develsvai/PROJECT_AC_SPOT_WELDER/firmware/new_architecture/sim_ui/index.html

# AC Spot Welder Simulator

이 화면은 단순 목업이 아니라 실제 `new_architecture` C 시뮬레이터 상태를 읽습니다. 버튼을 누르거나 시간을 진행시키면 LCD, UI 상태, Process 상태, Auto Detect 상태가 같이 변해야 정상입니다.

Virtual Time

0 ms

실제 시간이 아니라 시뮬레이터 내부에서 흐른 가상 시간입니다.

Time

50 ms

Multiplier

1

Rest

200 ms

Mode

MANUAL

Apply Settings Reload Visible Values

## Spot Progress

READY

용접 입력을 기다리는 상태입니다.

## Live State

UI State

Process State

Auto Detect

Current Menu

Pulse Count

0

Weld Count

0

TRIAC output active

Buzzer active

Contact stimulus active

Spot currently firing

## State Meaning

UI

현재 화면 상태 설명

Process

현재 용접 FSM 설명

Auto Detect

현재 자동 감지 상태 설명

Menu

현재 선택된 메뉴 항목 설명

## Event Log

최신 로그가 위에 쌓입니다. 자동 스팟은 보통 `접촉 감지 -> 대기 -> 펄스 출력 -> 완료 -> lockout` 순으로 보면 됩니다.

## Controls

Manual Weld

수동 모드 전용입니다. 이제 시뮬레이터에서는 버튼을 누르면 필요한 시간까지 자동으로 흘려서 결과가 바로 보입니다.

Manual Weld

Contact Input

AUTO 모드에서는 `Touch Pulse`가 가장 직관적입니다. 접촉을 한번 만들고 해제해서 자동 감지와 용접을 한 사이클로 보여줍니다.

Contact Off Touch Pulse

Simulation Tools

`Warm Up 1s`는 부팅 직후 splash를 넘기고 auto detect baseline을 안정시키는 용도입니다. `Reset`은 초기 상태로 되돌립니다.

Warm Up 1s Reset
