develsvai/PROJECT_AC_SPOT_WELDER/assets/images/board.png

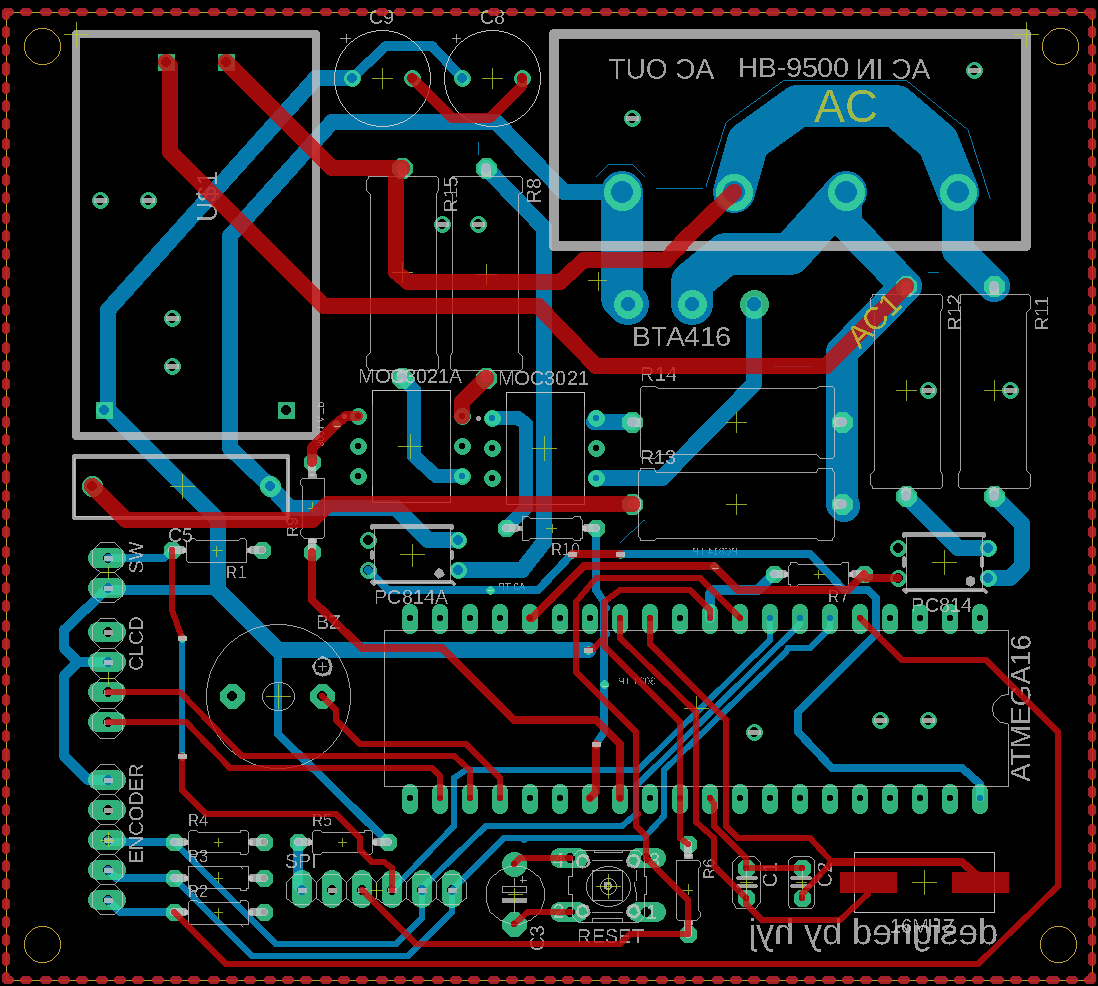
assets/images/board.png
