develsvai/PROJECT_AC_SPOT_WELDER/assets/images/board_3D_1.png

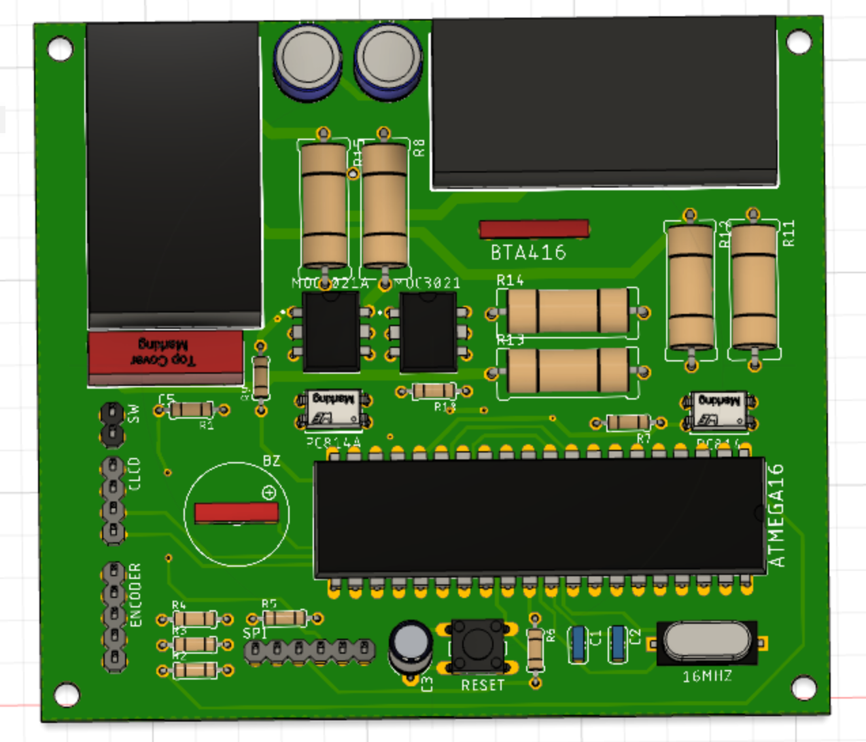
assets/images/board_3D_1.png
