develsvai/PROJECT_AC_SPOT_WELDER/assets/images/board_3D_2.png

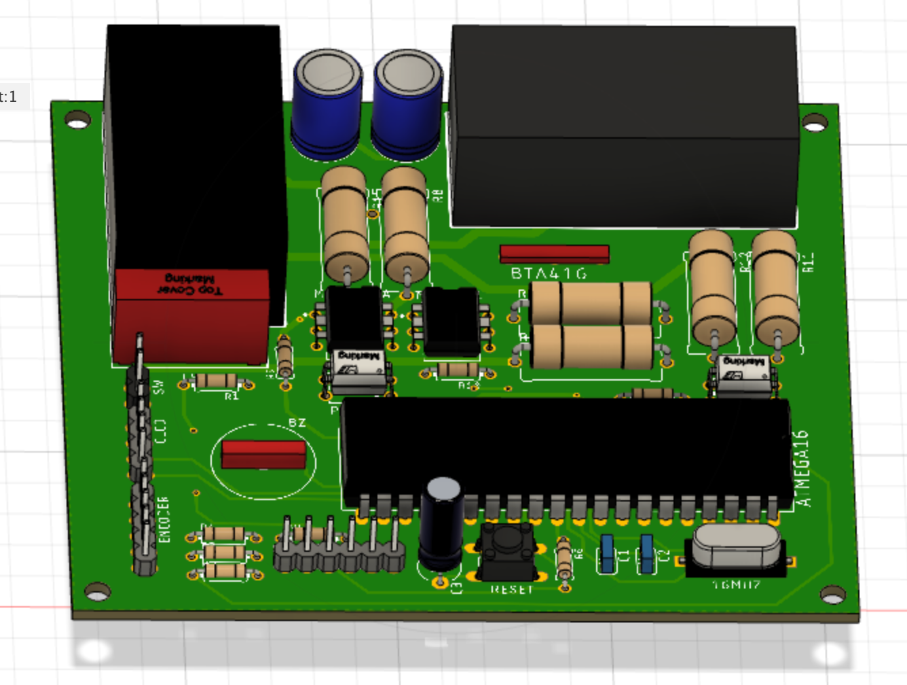
assets/images/board_3D_2.png
