develsvai/PROJECT_AC_SPOT_WELDER/assets/images/pcb_board_bottom.png

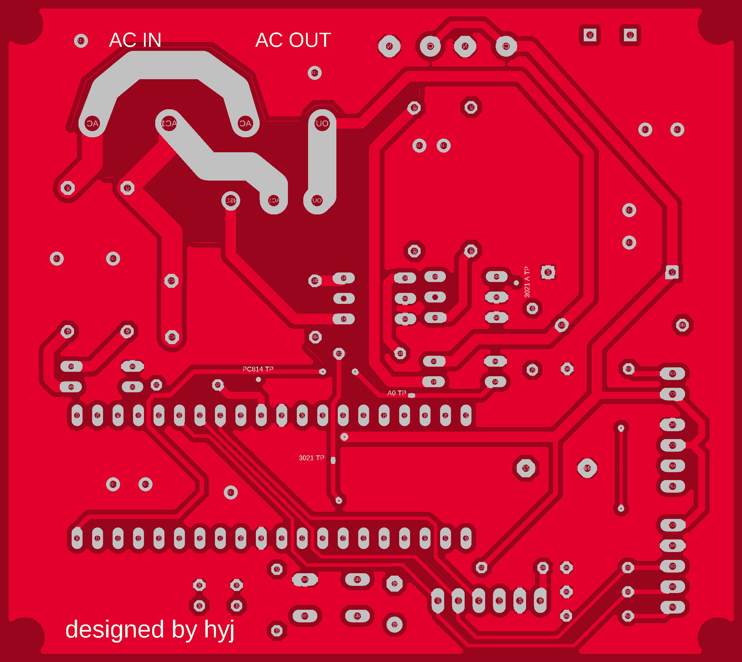
assets/images/pcb_board_bottom.png
