develsvai/PROJECT_AC_SPOT_WELDER/assets/images/pcb_board_top.png

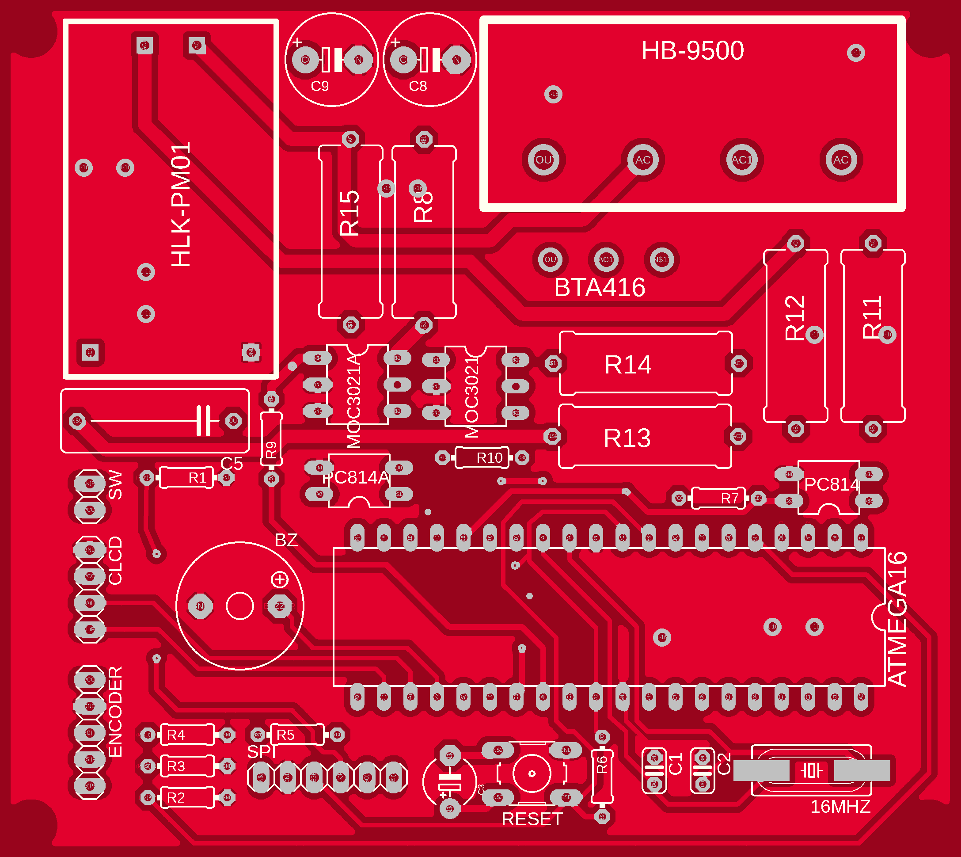
assets/images/pcb_board_top.png
