develsvai/PROJECT_AC_SPOT_WELDER/assets/images/product_1.jpeg

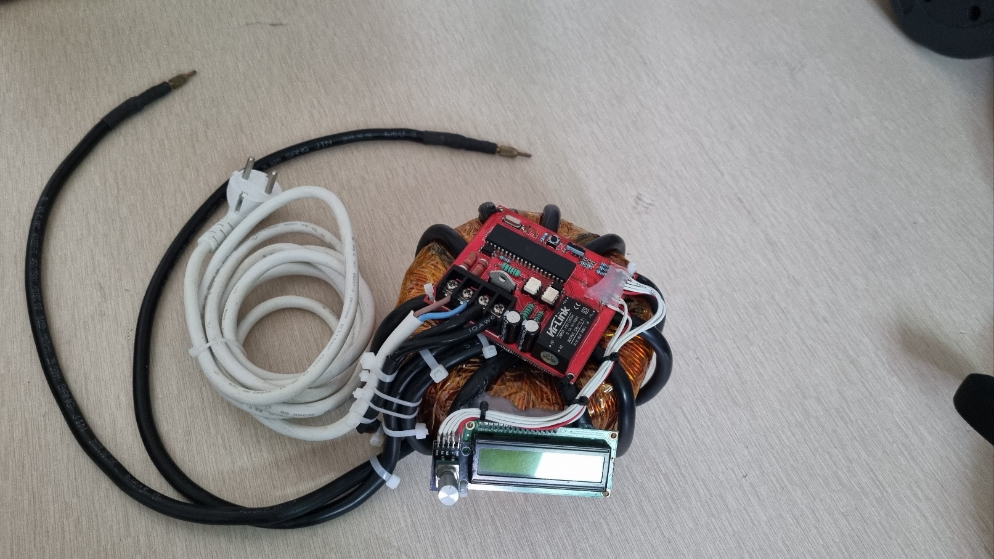
assets/images/product_1.jpeg
