develsvai/PROJECT_AC_SPOT_WELDER/assets/images/product_2.jpeg

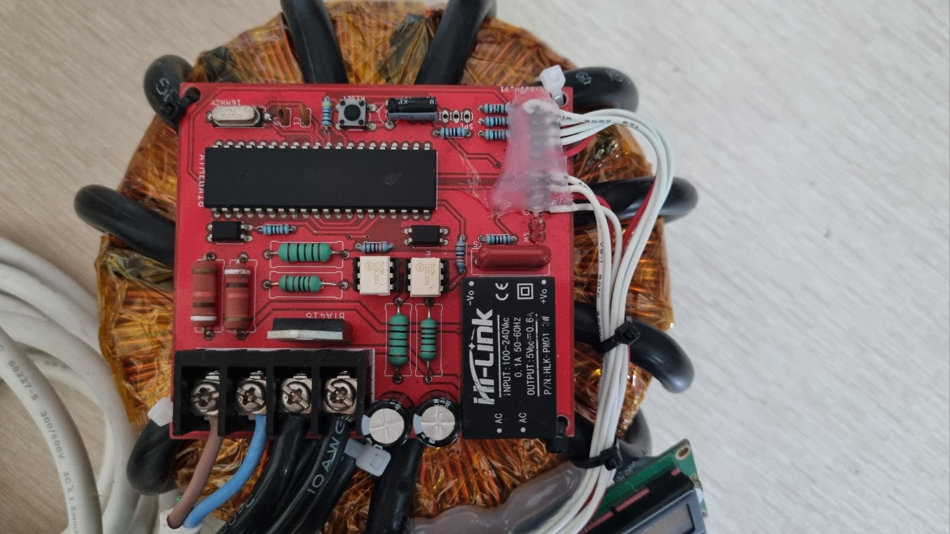
assets/images/product_2.jpeg
