develsvai/PROJECT_AC_SPOT_WELDER/assets/images/shema.png

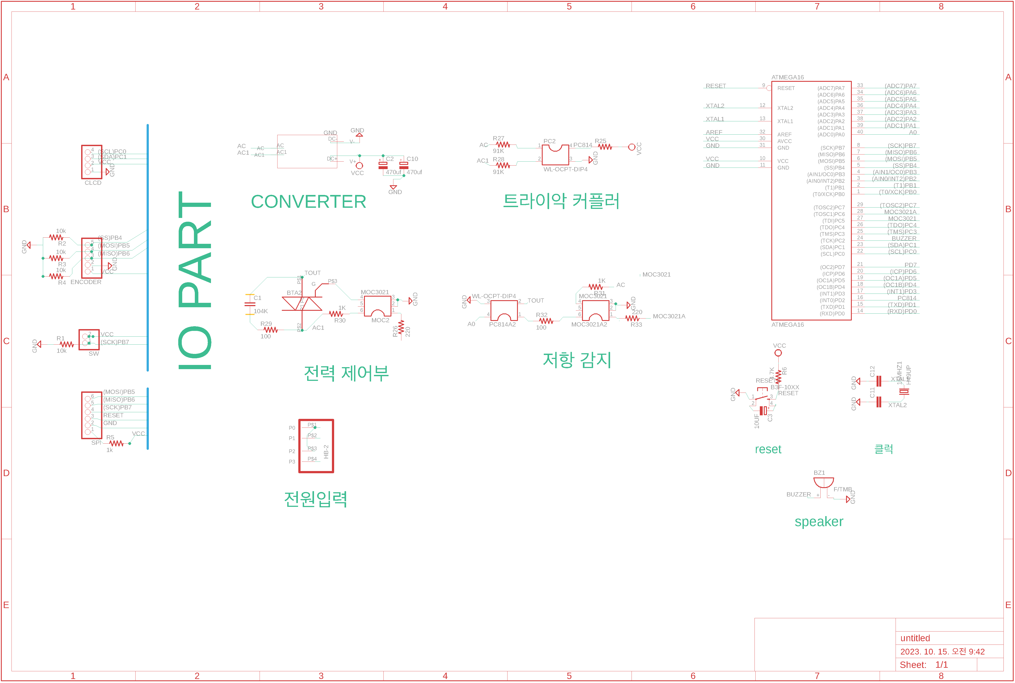
assets/images/shema.png
