develsvai/PROJECT_AC_SPOT_WELDER/docs/bom-cost/part_list.md

# AC SPOT Part List

원본 파일: `AC SPOT PART LIST.cell.xlsm`

## 기준 정보

- 기준 환율: 1달러 = 1102원
- 시트명: `Sheet1`

## 부품 목록

| 이름 | 개수 | 개당 달러 | 개당 원화 | 총가격(원화) | 총가격(달러) | 기타 설명 | 구입처 | 사이트주소 |
| --- | ---: | ---: | ---: | ---: | ---: | --- | --- | --- |
| atmega16 | 25 | 3.3755 | 3719.801 | 92995.025 | 84.3875 | mcu / AVR | LCSC | https://lcsc.com/product-detail/ATMEL-AVR_Microchip-Tech-ATMEGA16A-PU_C30504.html |
| moc3021 | 50 | 0.2382 | 262.4964 | 13124.82 | 11.91 | photo coupler | LCSC | https://lcsc.com/product-detail/Triac-Optocouplers_ON-Semiconductor-MOC3021M_C5242.html |
| pc814 | 40 | 0.1077 | 118.6854 | 4747.416 | 4.308 | photo coupler | LCSC | https://lcsc.com/product-detail/Optocouplers_Sharp-Microelectronics-PC814X1CSZ9F_C194288.html |
| 16Mhz | 30 | 0.1169 | 128.8238 | 3864.714 | 3.507 | crystal / 16MHZ | LCSC | https://lcsc.com/product-detail/SMD-Crystal-Resonators_Yangxing-Tech-X49SM16MSD2SC_C12676.html |
| 0.1uf | 50 | 0.1452 | 160.0104 | 8000.52 | 7.26 | mylar capacitor | LCSC | https://lcsc.com/product-detail/Mylar-Capacitor_NISSEI-MMCV0630K104C000D210_C359278.html |
| 470uf | 60 | 0.0321 | 35.3742 | 2122.452 | 1.926 | electrolytic capacitor / electrolytic condenser |  | https://lcsc.com/product-detail/Aluminum-Electrolytic-Capacitors-Leaded_CX-Dongguan-Chengxing-Elec-C43823_C43823.html |
| 10uf | 50 | 0 | 0 | 0 | 0 | electrolytic capacitor |  |  |
| HB9500 | 25 | 0.12 | 132.24 | 3306 | 3 | barrier terminal | LCSC | https://lcsc.com/product-detail/Barrier-Terminal-Blocks_Ningbo-Kangnex-Elec-HB9500-9-5-4P_C72338.html |
| 4.7K | 100 | 0.011 | 12.122 | 1212.2 | 1.1 | resistor / 1/4W | LCSC | https://lcsc.com/product-detail/Metal-Film-Resistor-TH_YAGEO-MFR-25FTE52-4K7_C173023.html |
| 220 | 100 | 0.0114 | 12.5628 | 1256.28 | 1.14 | resistor / 1/4W | LCSC | https://lcsc.com/product-detail/Metal-Film-Resistor-TH_YAGEO-MFR-25JT-52-220R_C176478.html |
| 10K | 100 | 0.0066 | 7.2732 | 727.32 | 0.66 | resistor / 1/4W | LCSC | https://lcsc.com/product-detail/Metal-Film-Resistor-TH_CCO-Chian-Chia-Elec-MF1-4W-10K%CE%A9-1-T52_C119347.html |
| 1K | 100 | 0.0145 | 15.979 | 1597.9 | 1.45 | resistor / 1W | LCSC | https://lcsc.com/product-detail/Metal-Film-Resistor-TH_UNI-ROYAL-Uniroyal-Elec-MFR01SF1001A10_C58688.html |
| 91K | 100 | 0 | 0 | 0 | 0 | resistor / 2W |  |  |
| 100 | 100 | 0.0166 | 18.2932 | 1829.32 | 1.66 | resistor / 1W | LCSC | https://lcsc.com/product-detail/Metal-Film-Resistor-TH_TyoHM-RN1WS100%CE%A9FT-BA1_C385268.html |
| HLK-PM01 | 25 | 2.7392 | 3018.5984 | 75464.96 | 68.48 | conveter / AC ->DC | LCSC | https://lcsc.com/product-detail/Power-Module-AC-DC_HI-LINK-HLK-PM01_C209903.html |
| DIP6 | 60 | 0.0288 | 31.7376 | 1904.256 | 1.728 | ic soket | LCSC | https://lcsc.com/product-detail/IC-Sockets_Ckmtw-Shenzhen-Cankemeng-ICS-6P_C146584.html |
| DIP40 | 30 | 0.0891 | 98.1882 | 2945.646 | 2.673 | ic soket | LCSC | https://lcsc.com/product-detail/IC-Sockets_BOOMELE-Boom-Precision-Elec-C2332_C2332.html |
| 20pf | 20 | 0.0093 | 10.2486 | 204.972 | 0.186 | ceramic capasitor | LCSC | https://lcsc.com/product-detail/Ceramic-Disc-Capacitors_Dersonic-CC1H200KA1PDCH4B3003_C353911.html |
| 1102A | 30 | 0.1269 | 139.8438 | 4195.314 | 3.807 | tack switch | LCSC | https://lcsc.com/product-detail/Tactile-Switches_C-K-PTS645SM502LFS_C285490.html |
| BTA416B | 25 | 1.3759 | 1516.2418 | 37906.045 | 34.3975 | AC TRIAC | LCSC | https://lcsc.com/product-detail/Thyristors-TRIACs_STMicroelectronics-BTA41-600BRG_C9103.html |
| 12c LCD | 20 | 2.69 | 2964.38 | 59287.6 | 53.8 | TWI CLCD | 메카솔루션 | http://mechasolution.com/shop/goods/goods_view.php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 |
| Rotary | 20 | 1.4 | 1542.8 | 30856 | 28 | rotary encoder | 협신전자 | https://smartstore.naver.com/ic11401/products/560078694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 |

## 합계

| 항목 | 값 |
| --- | ---: |
| 총 수량 | 1160개 |
| 총가격(원화) | 347548.76원 |
| 총가격(달러) | 315.38달러 |
