develsvai/PROJECT_AC_SPOT_WELDER/docs/bom-cost/지출 내역.md

# AC SPOT 지출 비용

## 자금 현황

- 소유 자본: 390000원
- 투자자금: 30만원

## 지출 항목

- 프로그램 비용: 8,1000원
- 기타 지출비용(식대): 14300원
- LCSC 부품 비용: 172839원
- 엔코더 로타리스위치: 25600원
- 메카솔루션 LCD&케이블: 66850원
- 용접봉 & 케이블: 30000원

## 지출 요약

- 지출 비용 총 합: 389599원
- 기타 지출 총합: 95300원
- 부품비 지출 총합: 29만 4900원

## 추가 필요 비용

- PCB 제작비용: 5만 (예상)
- 기타 박스,등등: 5만 이하 예상
- 총합: 10만

## 수익 예상

- 예상 단가: 40000원
- 손익분기: 40만
- 예상수익: 40만
