develsvai/PROJECT_AC_SPOT_WELDER/(list of files, cad)

Other CAD files:
hardware/ac-spot-control-board/Untitled.skp
