develsvai/PROJECT_AC_SPOT_WELDER/hardware/ac-spot-control-board/untitled.brd

## EAGLE design hardware/ac-spot-control-board/untitled.brd (2023-09-08)

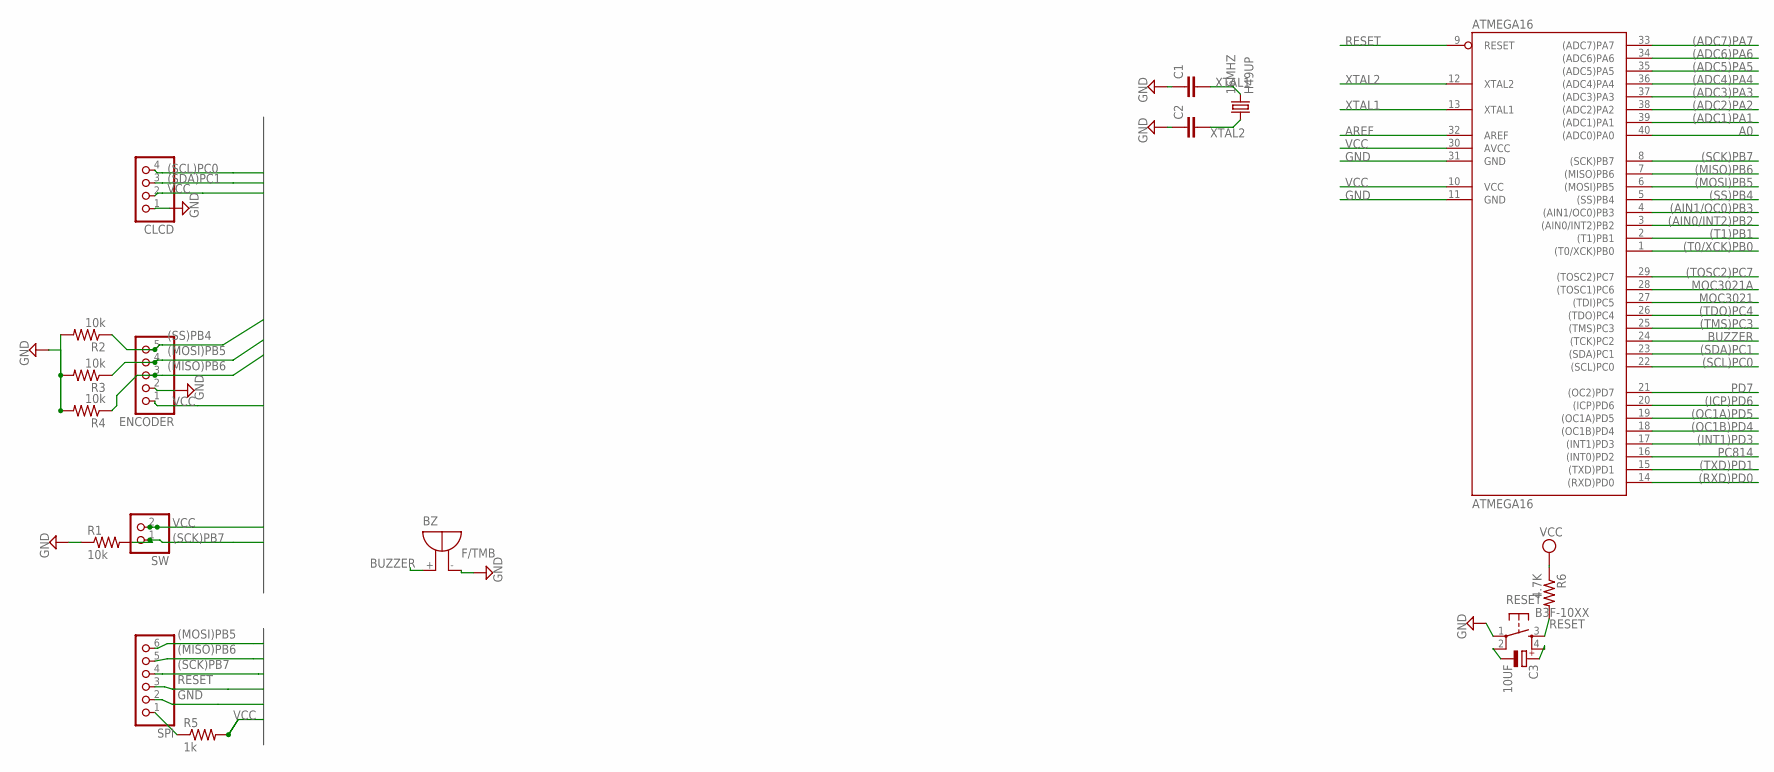
[picture p24: schematic untitled.sch, sheet 1]

Parts:
16MHZ: H49UP; XTAL1170X490X450N
ATMEGA16: ATMEGA16; DIL40
BZ: F/TMB
C1, C2: C-EU025-024X044; C025-024X044
C3: 10UF; E5-5
CLCD: PINHD-1X4; 1X04
ENCODER: PINHD-1X5; 1X05
R1, R2, R3, R4: 10k; 0204/7
R5: 1k; 0204/7
R6: 4.7K; 0204/7
RESET: B3F-10XX
SPI: PINHD-1X6; 1X06
SW: PINHD-1X2; 1X02

Connections:
(ADC1)PA1: ATMEGA16.39 ((ADC1)PA1)
(ADC2)PA2: ATMEGA16.38 ((ADC2)PA2)
(ADC3)PA3: ATMEGA16.37 ((ADC3)PA3)
(ADC4)PA4: ATMEGA16.36 ((ADC4)PA4)
(ADC5)PA5: ATMEGA16.35 ((ADC5)PA5)
(ADC6)PA6: ATMEGA16.34 ((ADC6)PA6)
(ADC7)PA7: ATMEGA16.33 ((ADC7)PA7)
(AIN0/INT2)PB2: ATMEGA16.3 ((AIN0/INT2)PB2)
(AIN1/OC0)PB3: ATMEGA16.4 ((AIN1/OC0)PB3)
(ICP)PD6: ATMEGA16.20 ((ICP)PD6)
(INT1)PD3: ATMEGA16.17 ((INT1)PD3)
(MISO)PB6: ATMEGA16.7 ((MISO)PB6), ENCODER.3, R4.1, SPI.5
(MOSI)PB5: ATMEGA16.6 ((MOSI)PB5), ENCODER.4, R3.1, SPI.6
(OC1A)PD5: ATMEGA16.19 ((OC1A)PD5)
(OC1B)PD4: ATMEGA16.18 ((OC1B)PD4)
(RXD)PD0: ATMEGA16.14 ((RXD)PD0)
(SCK)PB7: ATMEGA16.8 ((SCK)PB7), R1.2, SPI.4, SW.1
(SCL)PC0: ATMEGA16.22 ((SCL)PC0), CLCD.4
(SDA)PC1: ATMEGA16.23 ((SDA)PC1), CLCD.3
(SS)PB4: ATMEGA16.5 ((SS)PB4), ENCODER.5, R2.1
(T0/XCK)PB0: ATMEGA16.1 ((T0/XCK)PB0)
(T1)PB1: ATMEGA16.2 ((T1)PB1)
(TDO)PC4: ATMEGA16.26 ((TDO)PC4)
(TMS)PC3: ATMEGA16.25 ((TMS)PC3)
(TOSC2)PC7: ATMEGA16.29 ((TOSC2)PC7)
(TXD)PD1: ATMEGA16.15 ((TXD)PD1)
A0: ATMEGA16.40 ((ADC0)PA0); also elsewhere on the board
AREF: ATMEGA16.32 (AREF)
BUZZER: ATMEGA16.24 ((TCK)PC2), BZ.+
GND: ATMEGA16.11 (GND), ATMEGA16.31 (GND), BZ.-, C1.1, C2.1, CLCD.1, ENCODER.2, R1.1, R2.2, R3.2, R4.2, RESET.1, SPI.2; also elsewhere on the board
MOC3021: ATMEGA16.27 ((TDI)PC5); also elsewhere on the board
MOC3021A: ATMEGA16.28 ((TOSC1)PC6); also elsewhere on the board
unnamed: R5.1, SPI.1
unnamed: C3.-, RESET.2 (P1)
unnamed: C3.+, RESET.4 (S1)
PC814: ATMEGA16.16 ((INT0)PD2); also elsewhere on the board
PD7: ATMEGA16.21 ((OC2)PD7)
RESET: ATMEGA16.9 (RESET), R6.2, RESET.3 (S), SPI.3
VCC: ATMEGA16.10 (VCC), ATMEGA16.30 (AVCC), CLCD.2, ENCODER.1, R5.2, R6.1, SW.2; also elsewhere on the board
XTAL1: 16MHZ.2, ATMEGA16.13 (XTAL1), C1.2
XTAL2: 16MHZ.1, ATMEGA16.12 (XTAL2), C2.2

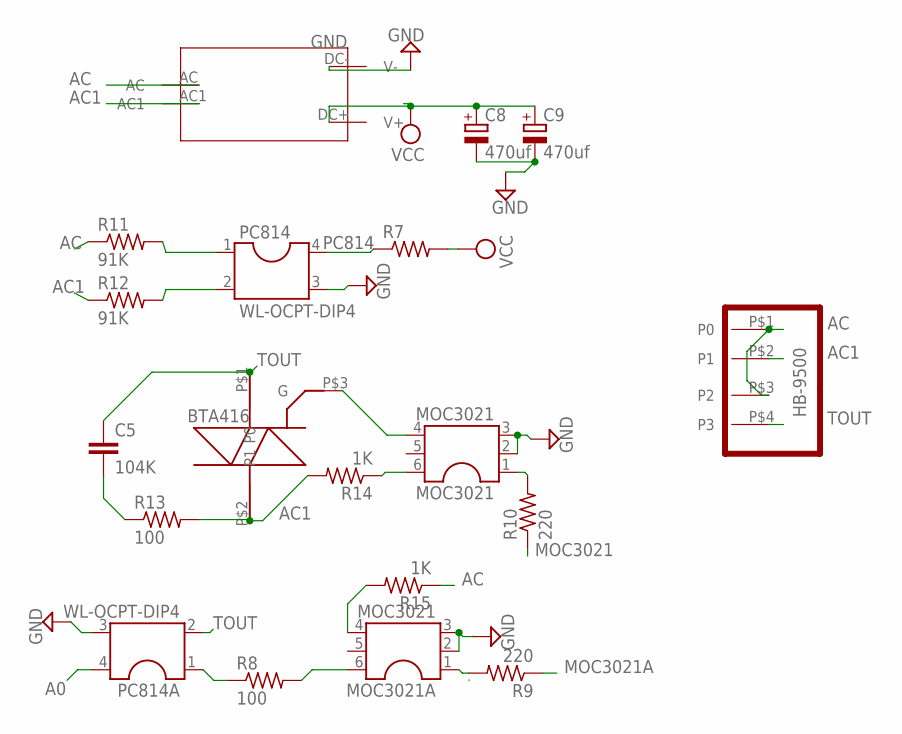
[picture p25: schematic untitled.sch, sheet 2]

Parts:
BTA416: BT41600B
C5: 104K; WCAP-FTX2_15X18X5X11(PXLXWXH)
C8, C9: 470uf; CAPPRD508W65D800H1100B
HB-9500: HB-9500
MOC3021, MOC3021A: MOC3021; DIP889W53P254L940H300Q6B
PC814, PC814A: WL-OCPT-DIP4; WL-OCPT_DIP4_STANDARD
R7: R-US_0204/7; 0204/7
R8, R13: 100; 0617/17
R9, R10: 220; 0204/7
R11, R12: 91K; 0617/17
R14, R15: 1K; 0617/17
U$1: HLK-PM01

Connections:
A0: PC814A.4; also elsewhere on the board
AC: HB-9500.P$1 (P0), HB-9500.P$3 (P2), R11.1, R15.1, U$1.AC
AC1: BTA416.P$2 (P1), HB-9500.P$2 (P1), R12.1, R13.2, R14.2, U$1.AC1
GND: C8.2 (-), C9.2 (-), MOC3021.2, MOC3021.3, MOC3021A.2, MOC3021A.3, PC814.3, PC814A.3, U$1.DC- (V-); also elsewhere on the board
MOC3021: R10.1; also elsewhere on the board
MOC3021A: R9.1; also elsewhere on the board
unnamed: MOC3021A.1, R9.2
unnamed: PC814.1, R11.2
unnamed: PC814.2, R12.2
unnamed: C5.2, R13.1
unnamed: BTA416.P$3 (G), MOC3021.4
unnamed: MOC3021.6, R14.1
unnamed: MOC3021.1, R10.2
unnamed: MOC3021A.4, R15.2
unnamed: MOC3021A.6, R8.2
unnamed: PC814A.1, R8.1
PC814: PC814.4, R7.1; also elsewhere on the board
TOUT: BTA416.P$1 (P0), C5.1, HB-9500.P$4 (P3), PC814A.2
VCC: C8.1 (+), C9.1 (+), R7.2, U$1.DC+ (V+); also elsewhere on the board

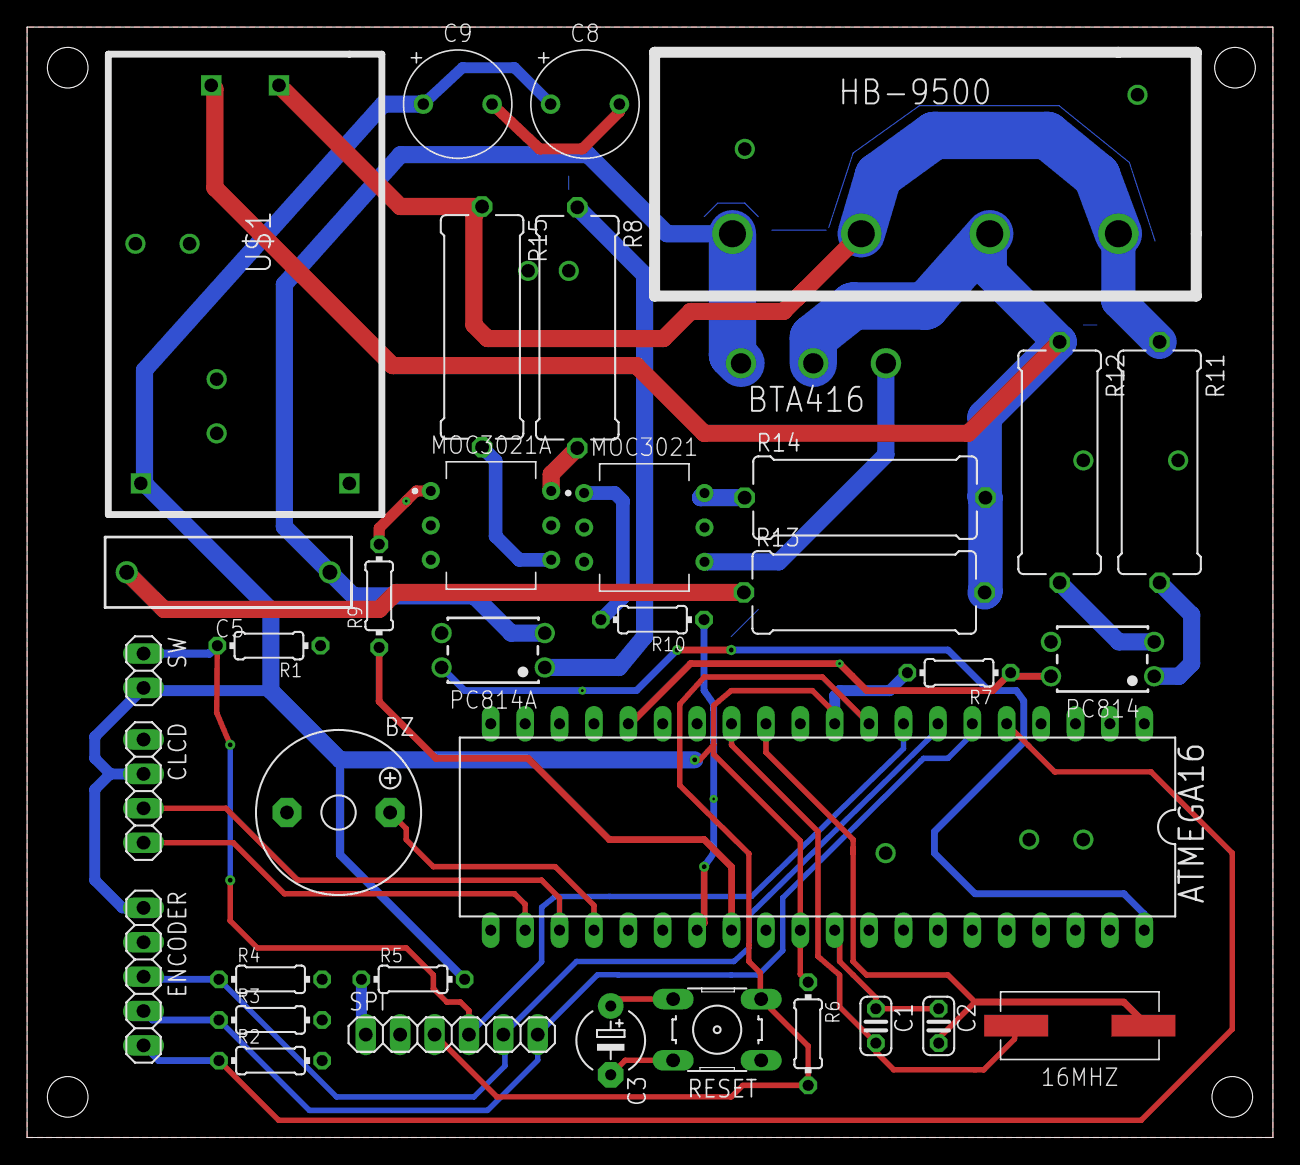
[picture p26: board untitled.brd from above]

Board: 2 copper layers, 92.0 x 82.0 mm, 36 parts (0 on the bottom side), 32 nets.
