develsvai/PROJECT_AC_SPOT_WELDER/(commit log)

2025-06-29 Refactor : 저항 번호 파일, 제로 크로싱 분석 파일 -> md 로 변경, 파일명 변경 , 코드 전체 리펙토링
2025-06-29 DS_Store 제거
2025-06-29 Update AC Power Control using an AVR Microcontroller.md
2025-06-29 Refactor : DS_store 제거, image 이름 변경
2026-03-15 Reorganize project structure and normalize docs
    [AC SPOT PART LIST.cell.xlsm, Untitled.skp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]
